Ardelean-Calin/Astropi-micro/04_Models_3d/CaseBottom.stl

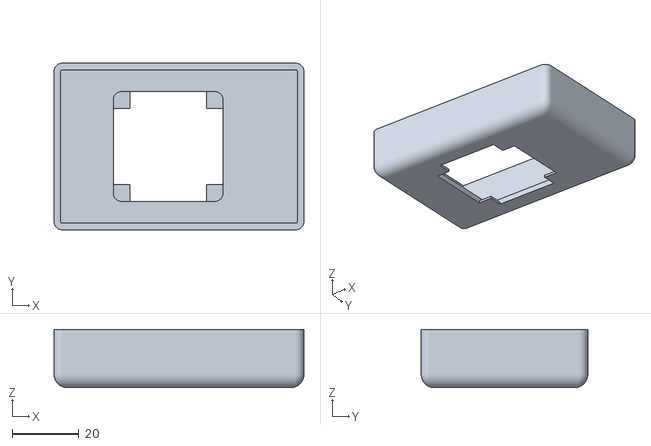
[picture p1: CAD file, 2020-07-08]
04_Models_3d/CaseBottom.stl
75.0 x 50.0 x 17.5
