Ardelean-Calin/Astropi-micro/04_Models_3d/CameraCap.stl

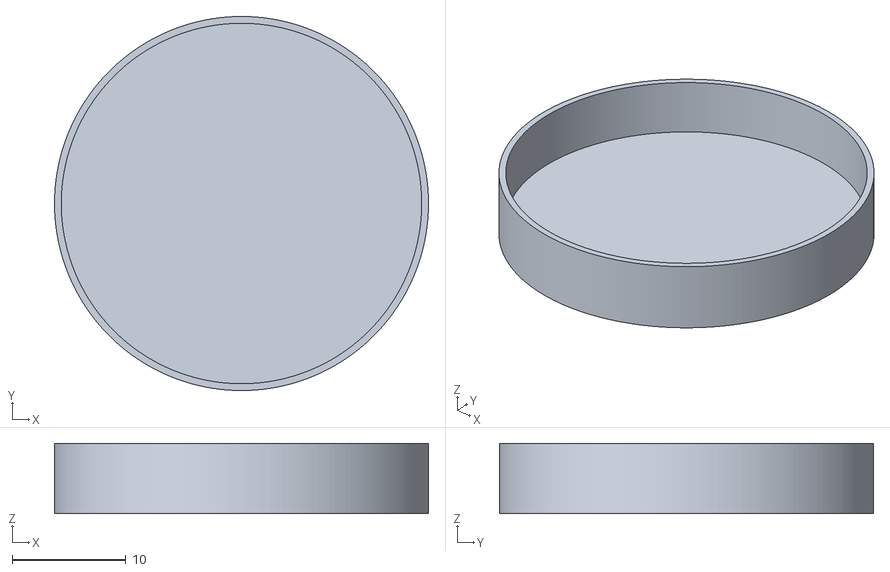
[picture p2: CAD file, 2020-07-08]
04_Models_3d/CameraCap.stl
33.0 x 32.9 x 6.20
