Ardelean-Calin/Astropi-micro/04_Models_3d/CameraMount.stl

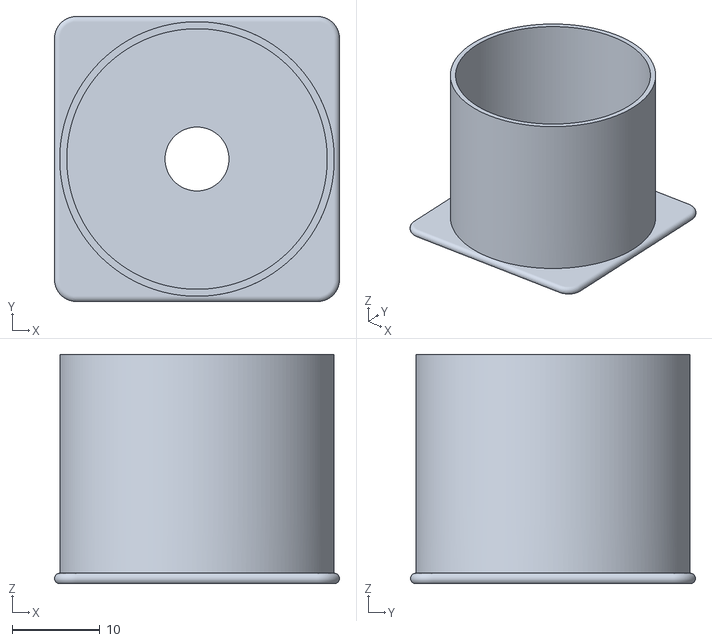
[picture p3: CAD file, 2020-07-08]
04_Models_3d/CameraMount.stl
32.5 x 32.5 x 26.2
