Ardelean-Calin/Astropi-micro/04_Models_3d/CaseTop.stl

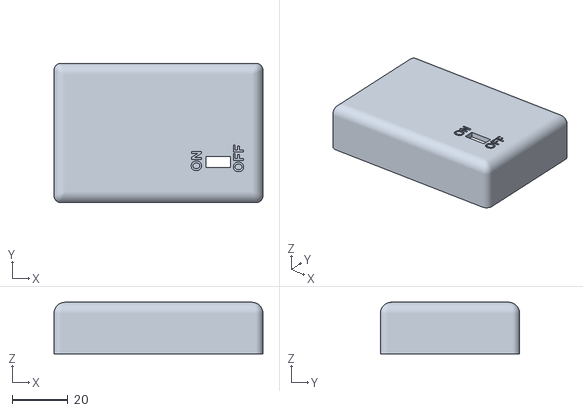
[picture p4: CAD file, 2020-07-08]
04_Models_3d/CaseTop.stl
75.0 x 50.0 x 18.5
