Ardelean-Calin/Astropi-micro/01_Hardware/AstroPiMicro.kicad_pcb

## KiCad design 01_Hardware/AstroPiMicro.kicad_pcb (2020-07-27)

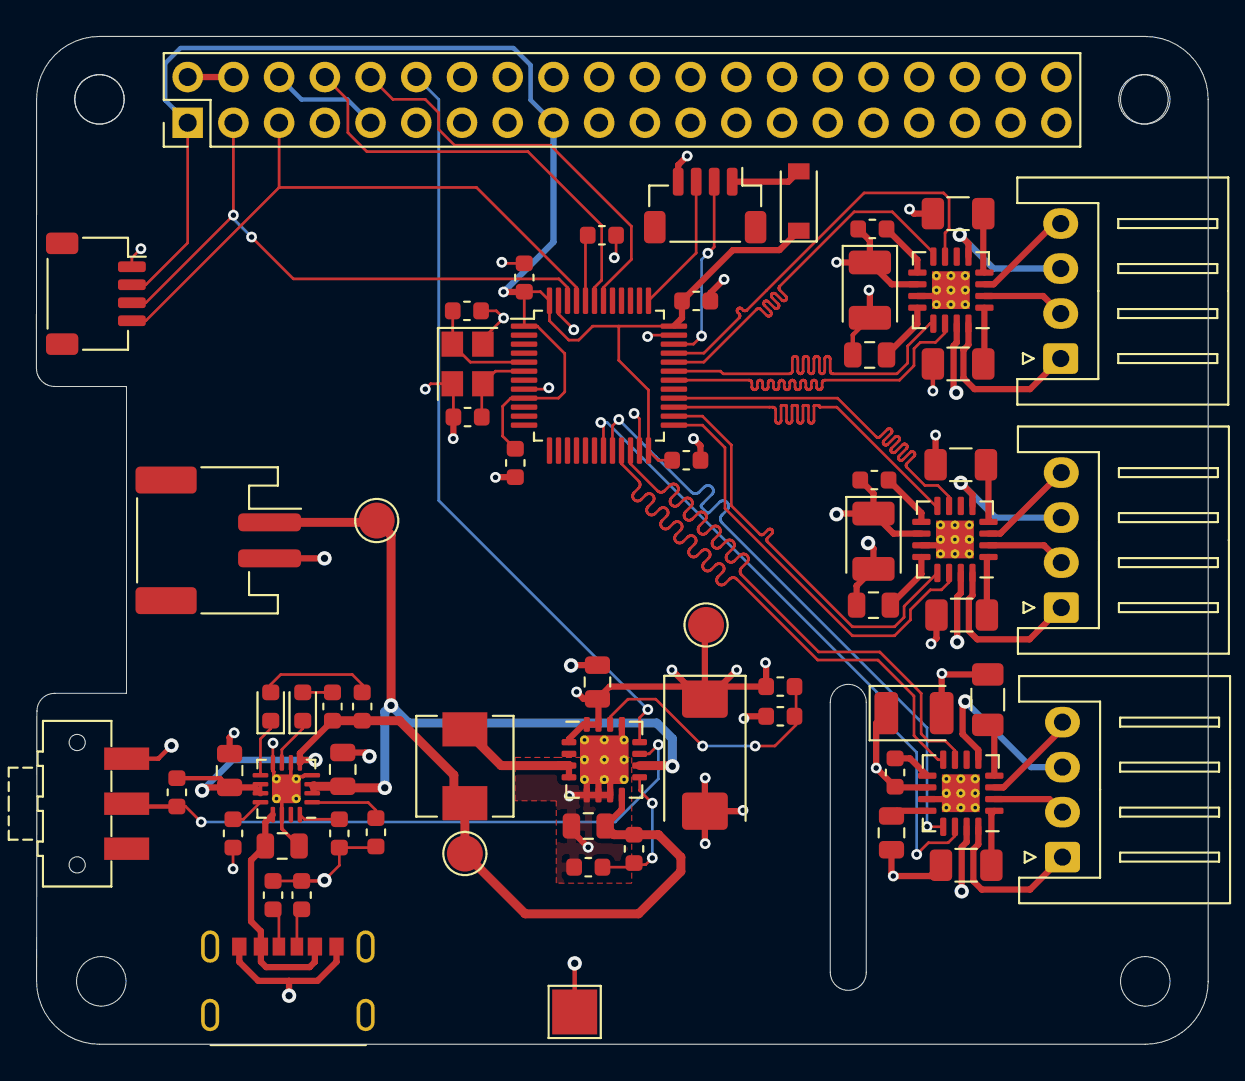
[picture p5: board AstroPiMicro.kicad_pcb from above]

Board: 4 copper layers, 65.1 x 56.0 mm, 65 parts (0 on the bottom side), 66 nets.

Parts:
C1, C5: 20pF; C_0603_1608Metric
C2: 1uF; C_0805_2012Metric
C3: 4.7uF; C_0805_2012Metric
C4, C8: 10uF; C_0805_2012Metric
C6, C13, C17: 47uF; CP_EIA-3528-15_AVX-H
C7, C19, C20, C21: 100nF; C_0603_1608Metric
C9, C12, C15, C18: 2.2uF; C_0805_2012Metric
C10: 100uF; CP_EIA-7343-15_Kemet-W
C11, C14, C16: 10nF; C_0603_1608Metric
D1: Green; LED_0603_1608Metric
D2: Orange; LED_0603_1608Metric
D3: B5819W; D_SOD-123
J1: RPi Connector; PinHeader_2x20_P2.54mm_Vertical
J2: SHOU_HAN_TYPE-C_6P; SHOU HAN TYPE-C 6P
J3: 2-pin JST PH; JST_PH_S2B-PH-SM4-TB_1x02-1MP_P2.00mm_Horizontal
J4: 4-pin JST SH; JST_SH_SM04B-SRSS-TB_1x04-1MP_P1.00mm_Horizontal
J5: Stepper_Focus; JST_XH_S4B-XH-A_1x04_P2.50mm_Horizontal
J6: Stepper_Azimuth; JST_XH_S4B-XH-A_1x04_P2.50mm_Horizontal
J7: Stepper_Altitude; JST_XH_S4B-XH-A_1x04_P2.50mm_Horizontal
J8: SWD; JST_SH_BM04B-SRSS-TB_1x04-1MP_P1.00mm_Vertical
L1: 10uH; L_Sunlord_MWSA0518_5.4x5.2mm
QR*****: MiniCalinGeani
R1: 1.1k; R_0603_1608Metric
R2, R6, R21: 10k; R_0603_1608Metric
R3: 1.5k; R_0603_1608Metric
R4, R5: 5k1; R_0603_1608Metric
R7, R8: 1k; R_0603_1608Metric
R9, R12: 2M; R_0603_1608Metric
R10: 390k; R_0603_1608Metric
R11, R14: 1; R_1206_3216Metric
R13: 220k; R_0603_1608Metric
R16, R17, R19, R20: 220m; R_1206_3216Metric
SW1: SW_SPDT; SW_SPDT_CK-JS102011SAQN
TP1: TP_VBAT; TestPoint_Pad_D2.0mm
TP2: TP_Supply; TestPoint_Pad_D2.0mm
TP3: TP_5V; TestPoint_Pad_D2.0mm
TP4: TP_GND; TestPoint_Pad_2.5x2.5mm
U1: BQ24074RGT; VQFN-16-1EP_3x3mm_P0.5mm_EP1.6x1.6mm_ThermalVias
U2: STM32F103C8Tx; LQFP-48_7x7mm_P0.5mm
U3, U5, U6: DRV8833RTY; Texas_S-PWQFN-N16_EP2.1x2.1mm_ThermalVias
U4: TPS61030; Texas_S-PVQFN-N16_EP2.7x2.7mm_ThermalVias
Y1: 16MHz; Crystal_SMD_3225-4Pin_3.2x2.5mm

Connections:
+3V3: C7.1, C19.1, C20.1, C21.1, D3.1, J1.1, J1.17, J4.2, U2.1, U2.9, U2.24, U2.36, U2.48
+5V: C6.1, C9.1, C10.1, C11.1, C13.1, C14.1, C16.1, C17.1, J1.2, J1.4, R12.1, TP3.1, U3.10, U3.15, U4.1, U4.15, U4.16, U5.10, U5.15, U6.10, U6.15
+BATT: C3.1, J3.1, TP1.1, U1.2, U1.3, U4.10
/A1_ALT: U2.19, U5.14
/A1_AZ: U2.30, U6.14
/A1_FOCUS: U2.25, U3.14
/A2_ALT: U2.20, U5.13
/A2_AZ: U2.31, U6.13
/A2_FOCUS: U2.26, U3.13
/Alt_A1: J7.1, U5.16
/Alt_A2: J7.2, U5.2
/Alt_B1: J7.3, U5.5
/Alt_B2: J7.4, U5.3
/Az_A1: J6.1, U6.16
/Az_A2: J6.2, U6.2
/Az_B1: J6.3, U6.5
/Az_B2: J6.4, U6.3
/B1_ALT: U2.22, U5.7
/B1_AZ: U2.33, U6.7
/B1_FOCUS: U2.28, U3.7
/B2_ALT: U2.21, U5.8
/B2_AZ: U2.32, U6.8
/B2_FOCUS: U2.27, U3.8
/Focus_A1: J5.1, U3.16
/Focus_A2: J5.2, U3.2
/Focus_B1: J5.3, U3.5
/Focus_B2: J5.4, U3.3
/IMU_SCL: J1.5, J4.4, U2.45
/IMU_SDA: J1.3, J4.3, U2.46
/ON\~OFF: R21.2, SW1.2, U4.11
/SWCLK: J8.3, U2.37
/SWDIO: J8.2, U2.34
/UART_RX: J1.10, U2.42
/UART_TX: J1.8, U2.43
/Vsupply: C4.1, C8.1, L1.1, R7.1, R8.1, R9.1, R21.1, TP2.1, U1.5, U1.10, U1.11, U4.8
/~LOW_BAT: J1.12, U4.12
GND: C1.2, C2.2, C3.2, C4.2, C5.2, C6.2, C7.2, C8.2, C9.2, C10.2, C12.2, C13.2, C15.2, C17.2, C18.2, C19.2, C20.2, C21.2, J1.6, J1.9, J1.14, J1.20, J1.25, J1.30, J1.34, J1.39, J2.A12, J2.B12, J2.S1, J3.2, J4.1, J8.4, R1.1, R2.2, R3.1, R4.1, R5.1, R6.2, R10.2, R11.2, R13.2, R14.2, R16.2, R17.2, R19.2, R20.2, SW1.1, TP4.1, U1.4, U1.6, U1.8, U1.14, U1.17, U2.8, U2.23, U2.35, U2.47, U3.11, U3.17, U4.5, U4.6, U4.7, U4.13, U4.17, U5.11, U5.17, U6.11, U6.17, Y1.2, Y1.4
unnamed: C1.1, U2.5, Y1.1
unnamed: C5.1, U2.6, Y1.3
unnamed: C11.2, U3.9
unnamed: C12.1, U3.12
unnamed: C14.2, U5.9
unnamed: C15.1, U5.12
unnamed: C16.2, U6.9
unnamed: C18.1, U6.12
unnamed: D1.1, U1.7
unnamed: D1.2, R7.2
unnamed: D2.1, U1.9
unnamed: D2.2, R8.2
unnamed: D3.2, J8.1
unnamed: J2.A5, R4.2
unnamed: J2.B5, R5.2
unnamed: L1.2, U4.3, U4.4
unnamed: R1.2, U1.12
unnamed: R2.1, U2.44
unnamed: R3.2, U1.16
unnamed: R6.1, U1.1
unnamed: R9.2, R10.1, U4.9
unnamed: R11.1, U3.1
unnamed: R12.2, R13.1, U4.14
unnamed: R14.1, U3.4
unnamed: R16.1, U5.1
unnamed: R17.1, U5.4
unnamed: R19.1, U6.4
unnamed: R20.1, U6.1
VBUS: C2.1, J2.A9, J2.B9, U1.13
