Ardelean-Calin/Astropi-micro/02_Firmware/AstropiMicro.ioc

Mcu.UserName=STM32G431KBTx
PA13.Signal=SYS_JTMS-SWDIO
PA14.Signal=SYS_JTCK-SWCLK
PA2.Signal=USART2_TX
PA3.Signal=USART2_RX
PA8.Signal=I2C2_SDA
PA9.Signal=I2C2_SCL
PF0-OSC_IN.Signal=RCC_OSC_IN
PF1-OSC_OUT.Signal=RCC_OSC_OUT
