Ardelean-Calin/Astropi-micro/(commit log)

2020-05-11 First hardware version
    [AstroPiMicro.kicad_pcb, AstroPiMicro.sch, ChargeAndBoost.sch]
2020-05-11 Finished board outline
    [AstroPiMicro.kicad_pcb, AstroPiMicro.sch]
2020-05-14 Routing finished.
    [AstroPiMicro.kicad_pcb, AstroPiMicro.sch]
2020-05-15 Added bom
2020-05-15 Removed unused files
    [ChargeAndBoost.sch]
2020-05-15 Almost all footprints have MFN now
    [AstroPiMicro.sch]
2020-05-17 Finished BOM, PCB and ordered PCB
    [AstroPiMicro-B_Cu.gbr, AstroPiMicro-B_Mask.gbr, AstroPiMicro-B_SilkS.gbr, AstroPiMicro-Edge_Cuts.gbr, AstroPiMicro-F_Cu.gbr, AstroPiMicro-F_Mask.gbr, AstroPiMicro-F_SilkS.gbr, AstroPiMicro-NPTH.drl]
2020-07-08 Hardware v1.0
    [AstroPiMicro.kicad_pcb, CameraCap.stl, CameraMount.stl, CaseBottom.stl, CaseTop.stl]
2020-07-17 Started on HW version 2
    [AstroPiMicro-B_Cu.gbr, AstroPiMicro-B_Mask.gbr, AstroPiMicro-B_SilkS.gbr, AstroPiMicro-Bottom.gbr, AstroPiMicro-Edge_Cuts.gbr, AstroPiMicro-F_Cu.gbr, AstroPiMicro-F_Mask.gbr, AstroPiMicro-F_SilkS.gbr]
2020-07-20 Ordered PCBs from JLCPCB
    [AstroPiMicro-B_Mask.gbr, AstroPiMicro-B_SilkS.gbr, AstroPiMicro-Bottom.gbr, AstroPiMicro-Edge_Cuts.gbr, AstroPiMicro-F_Mask.gbr, AstroPiMicro-F_SilkS.gbr, AstroPiMicro-In1.gbr, AstroPiMicro-In2.gbr]
2020-07-27 Changed layers to Sig, GND, PWR, Sig
    [AstroPiMicro.kicad_pcb, AstroPiMicro.sch]
